mgeders/QwiicPit/(commit log)

2020-07-30 Working Encoder Example That I Need To Incorporate
2020-07-30 An example I found for a sim racing button box
    Perhaps this code could be incorporated somehow rather than relying on the encoder library?
